riadlebbouz/StationMeteo_G1/station meteo/Core/Src/main.c

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
/* Includes ------------------------------------------------------------------*/
#include "main.h"
#include "fatfs.h"

/* USER CODE BEGIN Includes */
#include "led_modes.h"
#include "test_composants.h"

/* USER CODE END Includes */

/* USER CODE BEGIN PD */
/* 1 = test du Serial Monitor (TP 1), 0 = fonctionnement normal (4 modes) */
#define TEST_SERIAL_MONITEUR 0
/* 1 = test du capteur DHT11 sur PB0 (TP 4), 0 = fonctionnement normal */
#define TEST_DHT11 0
/* 1 = test du RTC interne (TP 5), 0 = fonctionnement normal */
#define TEST_RTC 0
/* 1 = test du capteur de luminosité BH1750 en I2C (TP 6), 0 = fonctionnement normal */
#define TEST_BH1750 0
/* 1 = test de la carte SD en SPI + FatFS (TP 7), 0 = fonctionnement normal */
#define TEST_SD 0
/* 1 = test du module GPS sur USART1 D8/D2 (TP 8), 0 = fonctionnement normal */
#define TEST_GPS 0
/* USER CODE END PD */

I2C_HandleTypeDef hi2c1;

RTC_HandleTypeDef hrtc;

SPI_HandleTypeDef hspi1;

UART_HandleTypeDef huart2;
UART_HandleTypeDef huart3;

void SystemClock_Config(void);
static void MX_GPIO_Init(void);
static void MX_I2C1_Init(void);
static void MX_RTC_Init(void);
static void MX_SPI1_Init(void);
static void MX_USART2_UART_Init(void);
static void MX_USART3_UART_Init(void);
/**
  * @brief  The application entry point.
  * @retval int
  */
int main(void)
{

  /* MCU Configuration--------------------------------------------------------*/

  /* Reset of all peripherals, Initializes the Flash interface and the Systick. */
  HAL_Init();

  /* Configure the system clock */
  SystemClock_Config();

  /* Initialize all configured peripherals */
  MX_GPIO_Init();
  MX_I2C1_Init();
  MX_RTC_Init();
  MX_SPI1_Init();
  MX_USART2_UART_Init();
  MX_USART3_UART_Init();
  MX_FATFS_Init();
  /* USER CODE BEGIN 2 */
  /* Un seul TEST_xxx à 1 = test d'un composant (Core/Src/test_*.c, ne revient jamais) ;
     tous à 0 = station normale (4 modes). */
#if TEST_SERIAL_MONITEUR
  Test_Serial();
#elif TEST_DHT11
  Test_DHT11();
#elif TEST_RTC
  Test_RTC(17, 56, 33, 16, 10, 26); /* heure, min, s, jour, mois, année (26 = 2026), réglée à chaque reset */
#elif TEST_BH1750
  Test_BH1750();
#elif TEST_SD
  Test_SD();
#elif TEST_GPS
  Test_GPS();
#else
  LedModes_Init(); /* LED RGB + 4 modes (boutons B1 et A4) */
#endif

  /* USER CODE END 2 */

  /* Infinite loop */
  /* USER CODE BEGIN WHILE */
  while (1)
  {
    /* USER CODE END WHILE */

    /* USER CODE BEGIN 3 */
    LedModes_Loop();
  }
  /* USER CODE END 3 */
}

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
/* USER CODE BEGIN 4 */
/* printf -> port série du ST-Link (USART2, 115200 bauds) */
int __io_putchar(int ch)
{
  uint8_t c = (uint8_t)ch;
  HAL_UART_Transmit(&huart2, &c, 1, 10);
  return ch;
}

/* USER CODE END 4 */
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
