riadlebbouz/StationMeteo_G1/station meteo/Core/Inc/main.h

#define BTN1_Pin GPIO_PIN_13
#define BTN1_GPIO_Port GPIOC
#define BTN1_EXTI_IRQn EXTI15_10_IRQn
#define BTN2_Pin GPIO_PIN_1
#define BTN2_GPIO_Port GPIOC
#define LED_R_Pin GPIO_PIN_0
#define LED_R_GPIO_Port GPIOA
#define LED_G_Pin GPIO_PIN_1
#define LED_G_GPIO_Port GPIOA
#define USART_TX_Pin GPIO_PIN_2
#define USART_TX_GPIO_Port GPIOA
#define USART_RX_Pin GPIO_PIN_3
#define USART_RX_GPIO_Port GPIOA
#define LED_B_Pin GPIO_PIN_4
#define LED_B_GPIO_Port GPIOA
#define SD_SCK_Pin GPIO_PIN_5
#define SD_SCK_GPIO_Port GPIOA
#define SD_MISO_Pin GPIO_PIN_6
#define SD_MISO_GPIO_Port GPIOA
#define SD_MOSI_Pin GPIO_PIN_7
#define SD_MOSI_GPIO_Port GPIOA
#define DHT11_Pin GPIO_PIN_0
#define DHT11_GPIO_Port GPIOB
#define GPS_TX_Pin GPIO_PIN_9
#define GPS_TX_GPIO_Port GPIOA
#define GPS_RX_Pin GPIO_PIN_10
#define GPS_RX_GPIO_Port GPIOA
#define SD_CS_Pin GPIO_PIN_6
#define SD_CS_GPIO_Port GPIOB
#define LUX_SCL_Pin GPIO_PIN_8
#define LUX_SCL_GPIO_Port GPIOB
#define LUX_SDA_Pin GPIO_PIN_9
#define LUX_SDA_GPIO_Port GPIOB
#define GPS_USART USART1
#define GPS_IRQn  USART1_IRQn
